Tom-Chassing/Projet_BancAvio/Core/Src/main.c

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
/* Includes ------------------------------------------------------------------*/
#include "main.h"
#include "fatfs.h"

/* USER CODE BEGIN Includes */
#include <stdio.h>
#include <string.h>
#include <stdarg.h> //for va_list var arg functions

#include "ssd1306.h"
#include "ssd1306_fonts.h"
#include "BME280_STM32.h"
#include "icm20948.h"
#include "math.h"
/* USER CODE END Includes */

I2C_HandleTypeDef hi2c1;

SPI_HandleTypeDef hspi3;

TIM_HandleTypeDef htim16;

UART_HandleTypeDef huart2;

/* USER CODE BEGIN PV */
#define SPI_CS_GPIO_Port GPIOB
#define SPI_CS_Pin GPIO_PIN_0

//Variables for FatFs deplaced here to be global and accessible in the whole file, 
//including in the main loop for file operations
//Evite aussi le Stack overflow qui peut arriver si on déclare ces grosses structures dans la fonction main
FATFS FatFs; 	//Fatfs handle
FIL fil; 		//File handle
FRESULT fres; //Result after operations

volatile uint8_t stop_logging = 0; // pour le BP d'arrêt et de reprise de l'acquisition
volatile uint8_t prev_stop_logging = 0; // pour détecter les changements d'état du flag
volatile uint32_t CTOP = 0; //Compteur de mesures pour limiter le nombre de fichiers créés sur la carte SD

/*------------Pour le gyroscope ICM20948------------*/
axises gyrodata;
axises acceldata;
axises magdata;

#define CENTER_X 30
#define CENTER_Y 40
#define RADIUS   18

#define HORIZON_CENTER_X 100
#define HORIZON_CENTER_Y 40
#define HORIZON_RADIUS   18

#define MAG_OFFSET_X 212.50f
#define MAG_OFFSET_Y 261.00f
#define MAG_OFFSET_Z 283.50f
/* USER CODE END PV */

void SystemClock_Config(void);
static void MX_GPIO_Init(void);
static void MX_USART2_UART_Init(void);
static void MX_I2C1_Init(void);
static void MX_SPI3_Init(void);
static void MX_TIM16_Init(void);
/* USER CODE BEGIN PFP */
void myprintf(const char *fmt, ...);
void draw_compass(float angle_degrees);
void draw_artificial_horizon(float pitch, float roll);
uint32_t calcul_rapport_cyclique(float yaw);
// Fonctions pour l'ARINC 429 
uint8_t inversion_byte(uint8_t byte);
int count_set_bits(uint32_t n);
uint32_t generate_arinc_word(uint32_t pressure, uint8_t label);
/* USER CODE END PFP */

/* USER CODE BEGIN 0 */
void myprintf(const char *fmt, ...) {
  static char buffer[256];
  va_list args;
  va_start(args, fmt);
  vsnprintf(buffer, sizeof(buffer), fmt, args);
  va_end(args);

  int len = strlen(buffer);
  HAL_UART_Transmit(&huart2, (uint8_t*)buffer, len, -1);

}
//Pur travail de l'IA; pour avoir une visualisation de l'orientation du gyroscope ICM20948
void draw_compass(float angle_degrees) {
    // 1. Convertir l'angle en radians
    float angle_rad = angle_degrees * (M_PI / 180.0f);

    // 2. Calculer les coordonnées du bout de l'aiguille
    int x_target = CENTER_X + (int)(RADIUS * sin(angle_rad));
    int y_target = CENTER_Y - (int)(RADIUS * cos(angle_rad)); // Moins car le Y de l'écran descend

    // 3. Dessiner le cadran du compas (Cercle extérieur)
    ssd1306_DrawCircle(CENTER_X, CENTER_Y, RADIUS, White);
    
    // 4. Dessiner un petit repère pour le "Nord" (Le haut de l'écran)
    ssd1306_Line(CENTER_X, CENTER_Y - RADIUS, CENTER_X, CENTER_Y - RADIUS + 5, White);

    // 5. Dessiner l'aiguille (Une simple ligne du centre vers le bord)
    ssd1306_Line(CENTER_X, CENTER_Y, x_target, y_target, White);
}
void draw_artificial_horizon(float pitch, float roll) {
    // 1. Convertir le roulis en radians
    float roll_rad = roll * (M_PI / 180.0f);

    // 2. Calculer le décalage vertical dû au tangage
    // Le facteur 0.5 est ajustable selon la sensibilité visuelle voulue
    int y_offset = (int)(pitch * 0.5f); 
    
    // On limite le décalage pour que la ligne ne sorte pas trop du cercle
    if (y_offset > HORIZON_RADIUS) y_offset = HORIZON_RADIUS;
    if (y_offset < -HORIZON_RADIUS) y_offset = -HORIZON_RADIUS;

    int center_y_line = HORIZON_CENTER_Y + y_offset;

    // 3. Calculer les décalages X et Y pour les extrémités de la ligne
    int dx = (int)(HORIZON_RADIUS * cos(roll_rad));
    int dy = (int)(HORIZON_RADIUS * sin(roll_rad));

    // 4. Dessiner le cadran extérieur
    ssd1306_DrawCircle(HORIZON_CENTER_X, HORIZON_CENTER_Y, HORIZON_RADIUS, White);
    
    // 5. Dessiner un point central statique (représente ton système/avion)
    ssd1306_Line(HORIZON_CENTER_X - 5, HORIZON_CENTER_Y, HORIZON_CENTER_X + 5, HORIZON_CENTER_Y, White);

    // 6. Dessiner la ligne d'horizon (qui pivote et monte/descend)
    ssd1306_Line(HORIZON_CENTER_X - dx, center_y_line - dy, HORIZON_CENTER_X + dx, center_y_line + dy, White);
}

uint32_t calcul_rapport_cyclique(float yaw){
    // On sait que le yaw varie entre -180° et +180°
    // On veut un rapport cyclique entre 5% de 20 ms = 1 ms (pour -180°) -> seroM à -90°
    // et 10% de 20 ms = 2 ms (pour +180°) -> servoM à +90°
    float nb_ticks = 1500 + (yaw / 360) * 1000;
    if (nb_ticks < 1000) nb_ticks = 1000;   // Limite inférieure
    if (nb_ticks > 2000) nb_ticks = 2000; // Limite supérieure

    return (uint32_t)nb_ticks;
}

/*-------------------------------
Fonctions pour l'ARINC 429
-------------------------------*/

uint8_t inversion_byte(uint8_t byte){
  //L'ARINC 429 inverse le balel, il donne d'abord le MSB et à la fin le LSB
  //Si notre label est 429 = 110101101, on doit envoyer 101101011 (0x5B) et pas 110101101 (0x6D)
  byte = (byte & 0xF0) >> 4 | (byte & 0x0F) << 4;
  byte = (byte & 0xCC) >> 2 | (byte & 0x33) << 2;
  byte = (byte & 0xAA) >> 1 | (byte & 0x55) << 1;
  //Exemple avec : 7654 3210
  //byte1 : 3210 7654
  //byte2 : 1032 5476
  //byte3 : 0123 4567
  return byte;
}

// Fonction pour compter le nombre de bits à 1 dans un entier (utile pour le bit de parité)
int count_set_bits(uint32_t n) {
    int compte = 0;
    while (n) {
        compte += n & 1;
        n >>= 1;
    }
    return compte;
}

uint32_t generate_arinc_word(uint32_t pressure, uint8_t label) {
    
    uint32_t arinc_word = 0; // On part d'un mot vide : 0000 0000 0000 0000 0000 0000 0000 0000

    // Le label (Bits 1 à 8)
    uint8_t label_reversed = inversion_byte(label);
    // On implémente ce label dans les 8 premiers bits du mot ARINC  
    arinc_word = arinc_word | label_reversed; 

    // SDI (Bits 9 et 10)
    // L'énoncé demande 0, donc on ne fait rien

    // La donnée pure (Bits 11 à 28)
    uint32_t data_masked = pressure & 0x3FFFF; // Sécurité pour ne garder que 18 bits de données, sans débordement
    arinc_word = arinc_word | (data_masked << 10);

    // SSM (Bits 30 et 31)
    // L'énoncé demande 0. On ne fait rienn.

    // Bit de parité (Bit 32)
    int ones_count = count_set_bits(arinc_word);
    
    // Si le nombre de '1' est pair, on doit mettre le 32ème bit à '1' pour que le total devienne impair.
    if (ones_count % 2 == 0) {
        arinc_word = arinc_word | ((uint32_t)1 << 31); 
        //uint32_t sur le '1' nécessaire apparemment pour ne pas avoir un bit signé qui causerait des problèmes lors du décalage
    }

    return arinc_word;
}
/* USER CODE END 0 */

/**
  * @brief  The application entry point.
  * @retval int
  */
int main(void)
{

  /* MCU Configuration--------------------------------------------------------*/

  /* Reset of all peripherals, Initializes the Flash interface and the Systick. */
  HAL_Init();

  /* Configure the system clock */
  SystemClock_Config();

  /* Initialize all configured peripherals */
  MX_GPIO_Init();
  MX_USART2_UART_Init();
  MX_I2C1_Init();
  MX_SPI3_Init();
  MX_FATFS_Init();
  MX_TIM16_Init();
  /* USER CODE BEGIN 2 */

  //Initialisation de l'écran OLED
  ssd1306_Init();

  /*------------------------------------------
  Capteur de temperature et de pression BMP280
  --------------------------------------------*/
 int status = BME280_Config (OSRS_2, OSRS_16, MODE_NORMAL, T_SB_0p5, IIR_16);
  if (status!= 0)
    {
  	  Error_Handler();
    }

  BME280_WakeUP();
  float temp=0;
  float press=0;
 
  /*------------------------------------------
  Carte SD + FatFS demo
  --------------------------------------------*/
  myprintf("TEST SPI EN COURS ...\r\n");

  //Force CS high
  //SD cards require CS to be high when power is applied
  HAL_GPIO_WritePin(SPI_CS_GPIO_Port, SPI_CS_Pin, GPIO_PIN_SET);
  HAL_Delay(10);

  // Envoie 10 octets 0xFF et affiche ce qu'on reçoit
  /*La norme exige de fournir un minimum de 74 impulsions d'horloge 
  avec la ligne de transmission (MOSI) maintenue à l'état haut (1) 
  avant de pouvoir envoyer la toute première commande.*/
  uint8_t tx = 0xFF, rx = 0x00;
  myprintf("Dummy bytes received: ");
  for(int i = 0; i < 10; i++) {
	  HAL_SPI_TransmitReceive(&hspi3, &tx, &rx, 1, 100);
	  myprintf("%02X ", rx);
  }
  myprintf("\r\n");

  // Force CS low et envoie CMD0 pour réveiller la carte SD
  HAL_GPIO_WritePin(SPI_CS_GPIO_Port, SPI_CS_Pin, GPIO_PIN_RESET);
  HAL_Delay(1);
  uint8_t cmd0[] = {0x40, 0x00, 0x00, 0x00, 0x00, 0x95}; //Norme de réveil pour les SD, 0x95 est le CRC correct pour CMD0
  uint8_t resp[7] = {0};
  HAL_SPI_Transmit(&hspi3, cmd0, 6, 100);

  // Lire 7 octets de réponse
  for(int i = 0; i < 7; i++) {
	  HAL_SPI_TransmitReceive(&hspi3, &tx, &resp[i], 1, 100);
	  myprintf("resp[%d] = %02X\r\n", i, resp[i]);
  }
  //Doit renvoyer "01" pour indiquer que le SD est en mode idle, prêt à recevoir des commandes

  HAL_GPIO_WritePin(SPI_CS_GPIO_Port, SPI_CS_Pin, GPIO_PIN_SET);

  myprintf("\r\n~ Fin de l'initialisation ~\r\n\r\n");

  HAL_Delay(1000); //a short delay is important to let the SD card settle

  //declaration of variables for FatFs deplaced to PV section
  
  //Open the file system
  fres = f_mount(&FatFs, "", 1); //1=mount now
  if (fres != FR_OK) {
  myprintf("f_mount error (%i)\r\n", fres);
  Error_Handler();
  }

  //Let's get some statistics from the SD card
  DWORD free_clusters, free_sectors, total_sectors;

  FATFS* getFreeFs;
  fres = f_getfree("", &free_clusters, &getFreeFs);
  if (fres != FR_OK) {
  myprintf("f_getfree error (%i)\r\n", fres);
  Error_Handler();
  }

  //Formula comes from ChaN's documentation
  total_sectors = (getFreeFs->n_fatent - 2) * getFreeFs->csize;
  free_sectors = free_clusters * getFreeFs->csize;

  myprintf("SD card stats:\r\n%10lu KiB total drive space.\r\n%10lu KiB available.\r\n", total_sectors / 2, free_sectors / 2);


  /*Créer un nom de fichier unique, à partir du numéro de session précédente */
  int i = 0;
  char nom_fichier[30];
  FILINFO fno;

  // Boucle pour trouver le premier numéro disponible
  do {
      snprintf(nom_fichier, sizeof(nom_fichier), "0:/VOL_%d.CSV", i); //info*
      i++;
  } while (f_stat(nom_fichier, &fno) == FR_OK); // FR_OK = le fichier existe, on continue
  //info* : snprintf(nom_fichier, sizeof(nom_fichier), équivalent de sprintf mais avec une sécurité de la taille du buffer pour éviter les débordements de mémoire
  
  i--; // On a trouvé un nom libre
  // Donc nom de fichier unique pour cette session qui est prêt à être utilisé pour l'écriture
  myprintf("Nom de fichier unique genere : %s\r\n", nom_fichier);

  /* ----------------------------------
  Gyroscope ICM20948
  --------------------------------- */
  //Initialisation des capteurs de mouvement
  icm20948_init();
  ak09916_init();
  // Angles
  float pitch = 0;
  float roll = 0;
  float yaw = 0;
  //Variables de corrections pour l'OFFSET du magnétomètre et l'inclinaison du capteur
  float pitch_rad = 0;
  float roll_rad = 0;
  float mx = 0;
  float my = 0;
  float mz = 0;
  float mag_x_comp = 0;
  float mag_y_comp = 0;


  /*------------------------------------------
  Variable de fréquence d'acquisition
  --------------------------------------------*/
  uint32_t last_tick = HAL_GetTick();

  /*------------------------------------------
  Pilotage PWM du servomoteur 
  -------------------------------------------*/
  float rapport_cyclique = 1500;
  HAL_TIM_PWM_Start(&htim16, TIM_CHANNEL_1);  // Start PWM on TIM1_CH1
  __HAL_TIM_SET_COMPARE(&htim16, TIM_CHANNEL_1, rapport_cyclique); //Initialisation à 1.5 ms, position neutre pour le servo

  /*------------------------------------------
  Message ARINC 429 
  --------------------------------------------*/
  //l'ARINC utilise l'octal pour le label ! Source : Wiki
  uint32_t mesg_arinc = 0 ;
  uint8_t label_arinc = 0xAE; //256 en octal, 174 en décimal, 0xAE en hexadécimal

  /*------------------------------------------
  Mise en place d'une LED pour signaler le mode "arrêt" de l'acquisition 
  -------------------------------------------*/
  // ~~~ Mode register : MODER ~~~
  GPIOA->MODER &= ~(0b11 << 22); // Reset state pour le pin 11; << 22 car pin 11 mais 2 bits par pin dans le registre MODER
  GPIOA->MODER |= 0b01 << 22; // Mise du pin 11 en mode "output" pour piloter la LED
  // ~~~ Output type register : OTYPER ~~~
  //Mise du pin 11 en "push-pull" pour un signal stable; <<11 car 1 bit/pin dans l'OTYPER
  GPIOA->OTYPER &= ~(0b1 << 11);
  // ~~~ Output speed register : OSPEEDR ~~~
  // Low speed car c'est une LED, pas besoin de haute fréquence, et ça évite les interférences électromagnétiques
  GPIOA->OSPEEDR &= ~(0b11 << 22);
  // ~~~ Pull-up/pull-down register : PUPDR ~~~
  // Pas de pull-up ni pull-down pour une sortie LED, une résistance est physiquement présente sur mon circuit
  GPIOA->PUPDR &= ~(0b11 << 22);
  // ~~~ Set/reset register : BSRR ~~~
  // Dans le BSRR, il y a le BR pour le reset et le BS pour le set. Un bit = 0 veut dire qu'il ne fait rien ("no action")
  // Le BR est mis à 1 pour éteindre la LED, le BS n'est pas utilisé, il reste à 0 pour ne pas allumer la LED
  GPIOA->BSRR = (0b1 << 27);

  /* USER CODE END 2 */

  /* Infinite loop */
  /* USER CODE BEGIN WHILE */
  while (1)
  {
    /* USER CODE END WHILE */

    /* USER CODE BEGIN 3 */
    if (stop_logging != prev_stop_logging) 
    {
      if (prev_stop_logging == 0) {
        GPIOA->BSRR = (0b1 << 11); //LED allumée en mode pause
        myprintf("Systeme | Acquisition en PAUSE\r\n");
      } else {
        GPIOA->BSRR = (0b1 << 27); //LED éteinte en mode acquisition
        myprintf("Systeme | Acquisition REPRISE\r\n");
      }
      prev_stop_logging = stop_logging;
    }

    if (HAL_GetTick() - last_tick >= 200) 
    { //Acquisition toutes les 200ms
      last_tick = HAL_GetTick(); //Reset du timer pour la prochaine acquisition

      if (stop_logging == 0){
        /*------------------------------------------
        Partie gyroscope ICM20948
        --------------------------------------------*/
        //Le capteur de temperature et de pression BMP280
        BME280_Measure(&temp,&press);
        
        //Le capteur de mouvement ICM20948 (gyroscope, accéléromètre et magnétomètre)
        icm20948_gyro_read(& gyrodata);
        icm20948_accel_read(& acceldata);
        ak09916_mag_read(& magdata); 
        mx = magdata.x - MAG_OFFSET_X;
        my = magdata.y - MAG_OFFSET_Y;
        mz = magdata.z - MAG_OFFSET_Z;
        // Calcul des angles
        pitch_rad = atan2(-acceldata.x, sqrt(acceldata.y * acceldata.y + acceldata.z * acceldata.z));
        roll_rad = atan2(acceldata.y, acceldata.z);
        pitch = pitch_rad * 180.0 / M_PI;
        roll = roll_rad * 180.0 / M_PI;

        mag_x_comp = mx * cos(pitch_rad) + mz * sin(pitch_rad);
        mag_y_comp = mx * sin(roll_rad) * sin(pitch_rad) + my * cos(roll_rad) - mz * sin(roll_rad) * cos(pitch_rad);
        yaw = atan2(mag_y_comp, mag_x_comp) * 180.0 / M_PI;

        /*------------------------------------------
        Partie message ARINC 429 pour la pression, à envoyer par UART et dans la microSD
        --------------------------------------------*/
        uint32_t press_dec = press * 100; //Pression*100 pour avoir les deux décimales
        mesg_arinc = generate_arinc_word(press_dec, label_arinc); 

        /*------------------------------------------
        Partie affichage Terminal Serie
        --------------------------------------------*/
        myprintf("Serial Terminal | T: %.2f C, P: %.2f hPa \r\n", temp, press);
        myprintf("Message ARINC | 0x%08lX\r\n", mesg_arinc); //%08lX repasse en hexadécimal long pour l'affichage, plus lisible pour un message binaire
        myprintf("ICM-20948 | Lacet : %.2f°\r\n", yaw);
        myprintf("ICM-20948 | Tagage : %.2f°\r\n", pitch);
        myprintf("ICM-20948 | Roulis : %.2f°\r\n", roll);

        /*------------------------------------------
        Partie affichage Écran OLED
        --------------------------------------------*/
        ssd1306_Fill(Black);

        ssd1306_SetCursor(2, 0);
        char strPress[20];
        sprintf(strPress, "P: %.2f hPa", press);
        ssd1306_WriteString(strPress, Font_7x10, White);
        
        ssd1306_SetCursor(2, 10);
        char strTemp[20];
        sprintf(strTemp, "T: %.2f C", temp);
        ssd1306_WriteString(strTemp, Font_7x10, White);

        draw_compass(yaw);
        draw_artificial_horizon(pitch, roll);

        ssd1306_UpdateScreen();

        /*------------------------------------------
        Partie écriture sur carte SD
        --------------------------------------------*/

        //Now let's try and write a file "write.txt"
        fres = f_open(&fil, nom_fichier, FA_WRITE | FA_OPEN_ALWAYS | FA_OPEN_APPEND);
        if(fres == FR_OK) {
        myprintf("SD | Ouverture de %s pour ecriture\r\n", nom_fichier);
        } else {
        myprintf("SD | Erreur f_open (%i)\r\n", fres);
        }

        char line[250];
        //Copy in a string
        //Format CSV : "temp;press;etc" car Excel sépare grace au "";"
        snprintf(line, sizeof(line), "%.2f;%.2f;%.2f;%.2f;%.2f;0x%08lX\r\n", temp, press, yaw, pitch, roll, mesg_arinc);
        UINT bytesWrote;
        fres = f_write(&fil, line, strlen(line), &bytesWrote);
        if(fres == FR_OK) {
        myprintf("SD | Wrote %i bytes to %s!\r\n", bytesWrote, nom_fichier);
        } else {
        myprintf("SD | f_write error (%i)\r\n", fres);
        }

        //Be a tidy kiwi - don't forget to close your file!
        f_close(&fil);

        /*------------------------------------------
        Pilotage servomoteur
        --------------------------------------------*/
        rapport_cyclique = calcul_rapport_cyclique(yaw);
        __HAL_TIM_SET_COMPARE(&htim16, TIM_CHANNEL_1, rapport_cyclique); 

        /*------------------------------------------
        LEDs d'alterte sur dépassement de seuils (40°) pour le tangage et le roulis
        --------------------------------------------*/
        // Vérification du Tangage (Pitch)
        if (fabs(pitch) > 40.0f) {
            HAL_GPIO_WritePin(GPIOA, GPIO_pitch_Pin, GPIO_PIN_SET);
        } else {
            HAL_GPIO_WritePin(GPIOA, GPIO_pitch_Pin, GPIO_PIN_RESET);
        }
        // Vérification du Roulis (Roll)
        if (fabs(roll) > 40.0f) {
            HAL_GPIO_WritePin(GPIOA, GPIO_roll_Pin, GPIO_PIN_SET);
        } else {
            HAL_GPIO_WritePin(GPIOA, GPIO_roll_Pin, GPIO_PIN_RESET);
        }

        /*------------------------------------------
        Limitation du nombre de mesures
        --------------------------------------------*/
        CTOP++;
        if (CTOP > 900) { //On s'arrête après 900 mesures, <=> 3 min d'acquisition pour éviter de remplir la carte SD
          myprintf("  ~~ limite (900) atteinte, arrêt de la journalisation ~~  \r\n");
          break;  
        }
      }
    }
  }
  //demontage de la carte SD pour éviter les corruptions de données
  f_mount(NULL, "", 0);
  myprintf("SD | Carte SD demontee en toute securite.\r\n");

  // Bloque le processeur ici indefiniment
  while(1) {
    //LED clignotante pour signaler la fin de l'acquisition
    GPIOA->BSRR = (0b1 << 11); 
    HAL_Delay(200);
    GPIOA->BSRR = (0b1 << 27);
    HAL_Delay(200);
  }
  /* USER CODE END 3 */
}

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
/* USER CODE BEGIN 4 */
void HAL_GPIO_EXTI_Callback(uint16_t GPIO_Pin)
{
  static uint32_t last_BPclick = 0; //statique pour conserver la valeur entre les appels de la fonction, corrigeant ma faute d'anti-rebond
  uint32_t actual_BPclick = 0;
  if(GPIO_Pin == BP_GPIO_EXTI8_Pin) 
  {
    actual_BPclick = HAL_GetTick();
    if (actual_BPclick - last_BPclick >= 200)
    {
      stop_logging = !stop_logging; // Inversion de l'état du flag}
      last_BPclick = actual_BPclick; // Mise à jour du temps du dernier clic pour éviter les rebonds
    }
  }
}
/* USER CODE END 4 */
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
