Tom-Chassing/Projet_BancAvio/Core/Inc/main.h

#define SD_SPI_HANDLE hspi3
#define MCO_Pin GPIO_PIN_0
#define MCO_GPIO_Port GPIOA
#define GPIO_pitch_Pin GPIO_PIN_1
#define GPIO_pitch_GPIO_Port GPIOA
#define VCP_TX_Pin GPIO_PIN_2
#define VCP_TX_GPIO_Port GPIOA
#define GPIO_roll_Pin GPIO_PIN_3
#define GPIO_roll_GPIO_Port GPIOA
#define SPI3_CS_Pin GPIO_PIN_0
#define SPI3_CS_GPIO_Port GPIOB
#define BP_GPIO_EXTI8_Pin GPIO_PIN_8
#define BP_GPIO_EXTI8_GPIO_Port GPIOA
#define BP_GPIO_EXTI8_EXTI_IRQn EXTI9_5_IRQn
#define SWDIO_Pin GPIO_PIN_13
#define SWDIO_GPIO_Port GPIOA
#define SWCLK_Pin GPIO_PIN_14
#define SWCLK_GPIO_Port GPIOA
#define VCP_RX_Pin GPIO_PIN_15
#define VCP_RX_GPIO_Port GPIOA
