Tom-Chassing/Projet_BancAvio/(commit log)

2026-05-18 Ajout et adaptation des FAFTS pour SPI
2026-05-19 Correction + Test de la µSD
    [BME280_STM32.c, Projet_BancAvio.ioc, main.c]
2026-05-20 ajout de libraire icm20948
2026-05-20 Ensemble avec gyro fonctionnel
2026-05-20 Ajout f_acquisition = 5Hz ; Fin de l'etapeGyro
2026-05-20 Servomoteur fonctionnel
2026-05-20 LEDs de dépassement (tangage & roulis)
2026-05-21 Correction du label et du PWM à l'init
    [main.c]
2026-05-23 Ajout d'une LED d'état d'acquisition, en baremetal
2026-05-23 Fix : anti-rebond & commentaire avec coquilles
    [main.c]
2026-05-24 Fix : autre coquille sur un commentaire
    [main.c]
2026-05-28 Rapport technique sur le projet de banc de test
